kocyns/LaserSprint-ESP32/docs/20261004_163319 - kopie.jpg

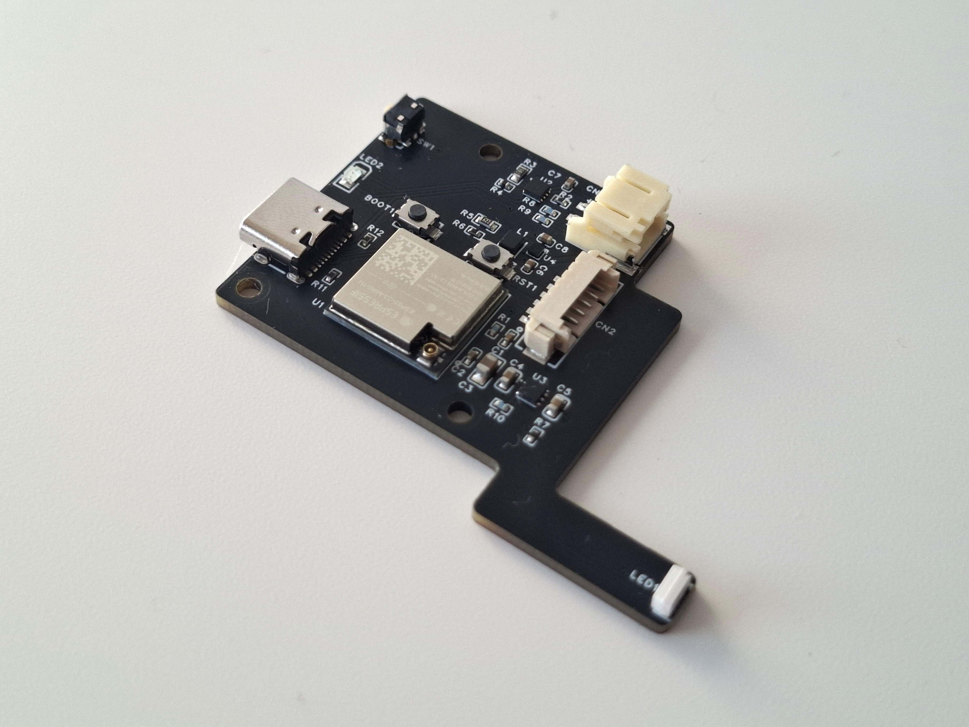
docs/20261004_163319 - kopie.jpg
