kocyns/LaserSprint-ESP32/docs/20261004_163330.jpg

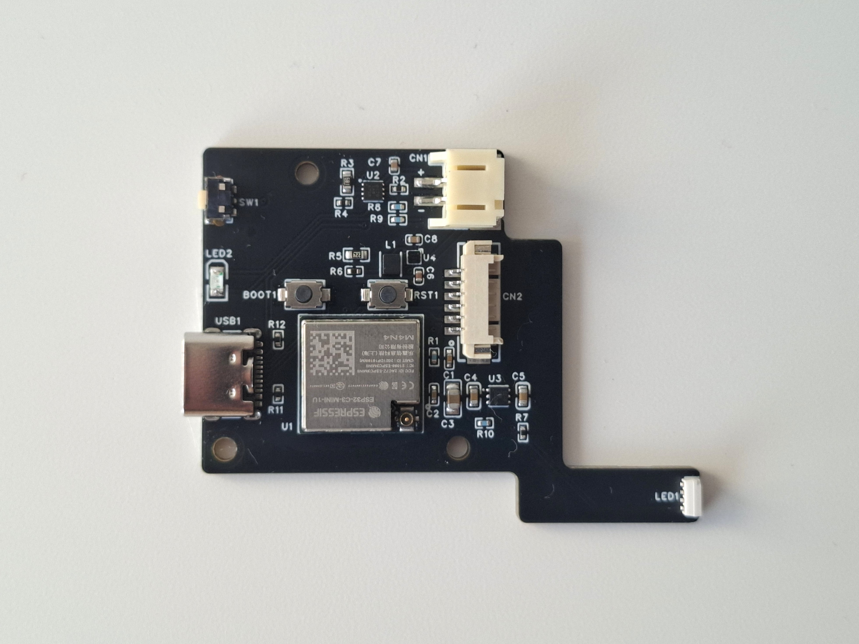
docs/20261004_163330.jpg
