kocyns/LaserSprint-ESP32/docs/EN_assembly_laser_sprint.pdf

# Assembly Guide

# Laser Sprint

V1.0

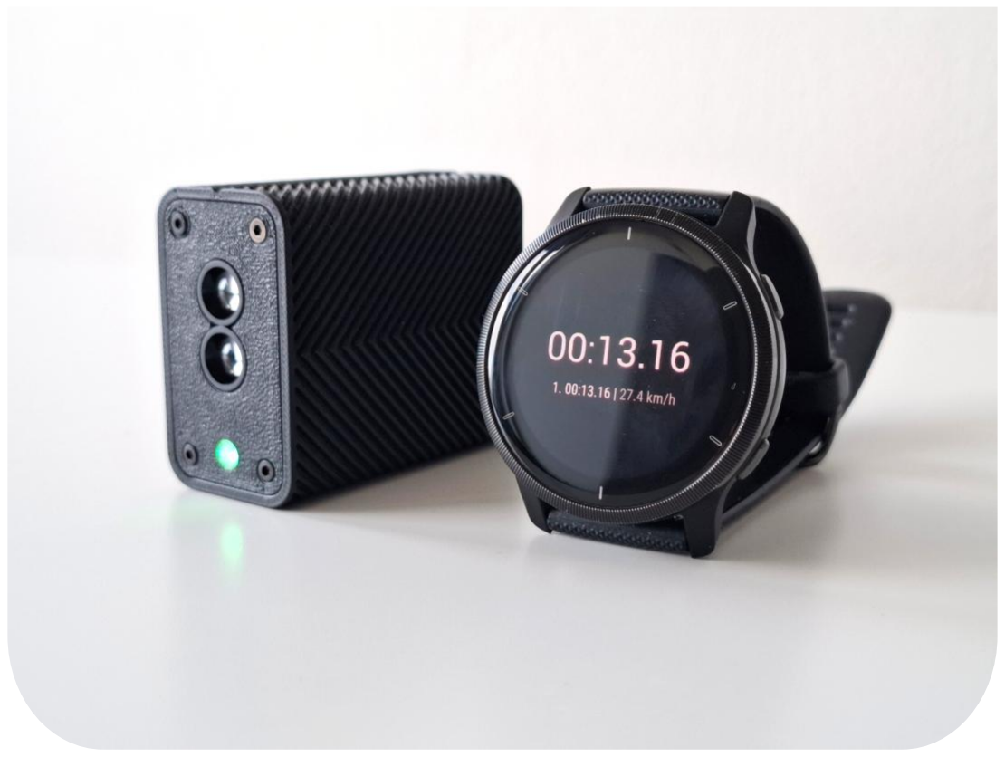
[picture p6: figure]

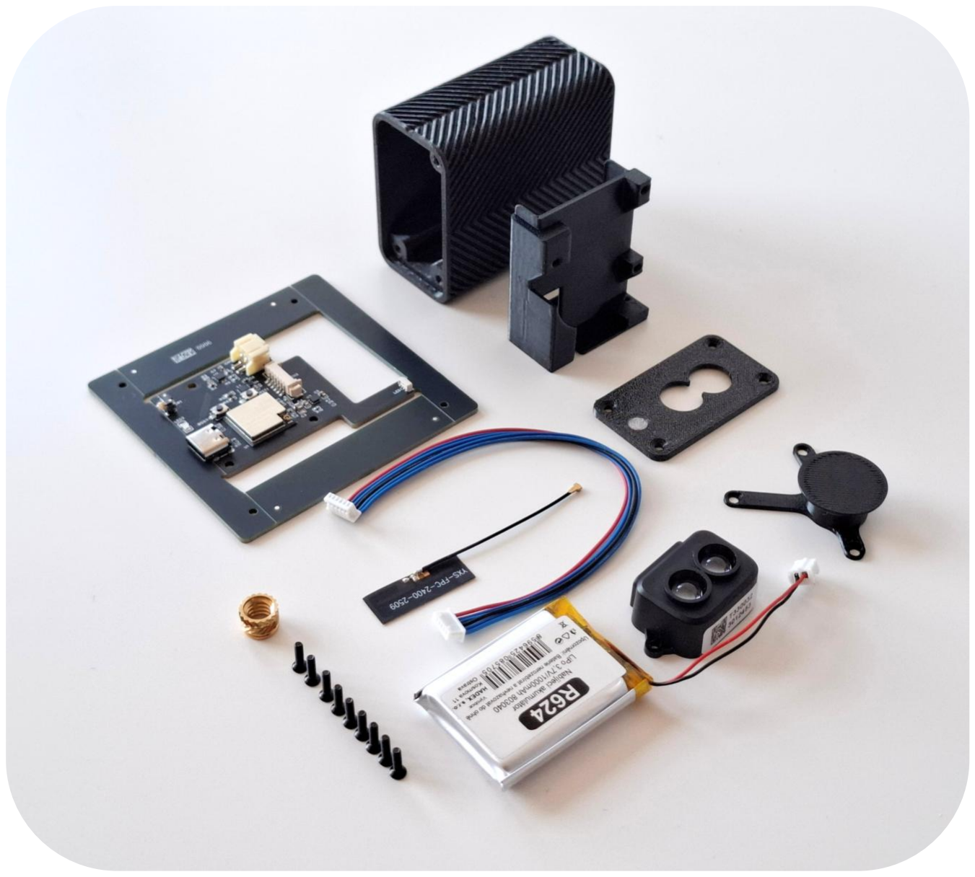
[picture p7: figure]

## What accessories/tools will you need?

- Custom PCB: • Pre-assembled Laser Sprint board ( (https://www.pcbway.com/project/shareproject/Laser_Sprint_5ba1c15b.html)PCBWay

) (https://www.pcbway.com/project/shareproject/Laser_Sprint_5ba1c15b.html)
- LiDAR Sensor: • TF-Luna ToF LiDAR
8m (UART)
- LiPo Battery: • 3.7V 1000mAh (Size 803040 / ~40 x30mm)
- BLE Antenna: • 2.4GHz 3dBi with IPEX

### 3 connector

- Tripod Mount: • 1/4"-20 UNC Threaded Brass Insert (Short) • Screws: • M2x8mm Screws for 3D Printed Case • 3D Printed Enclosure • Download 3D model MakerWorld

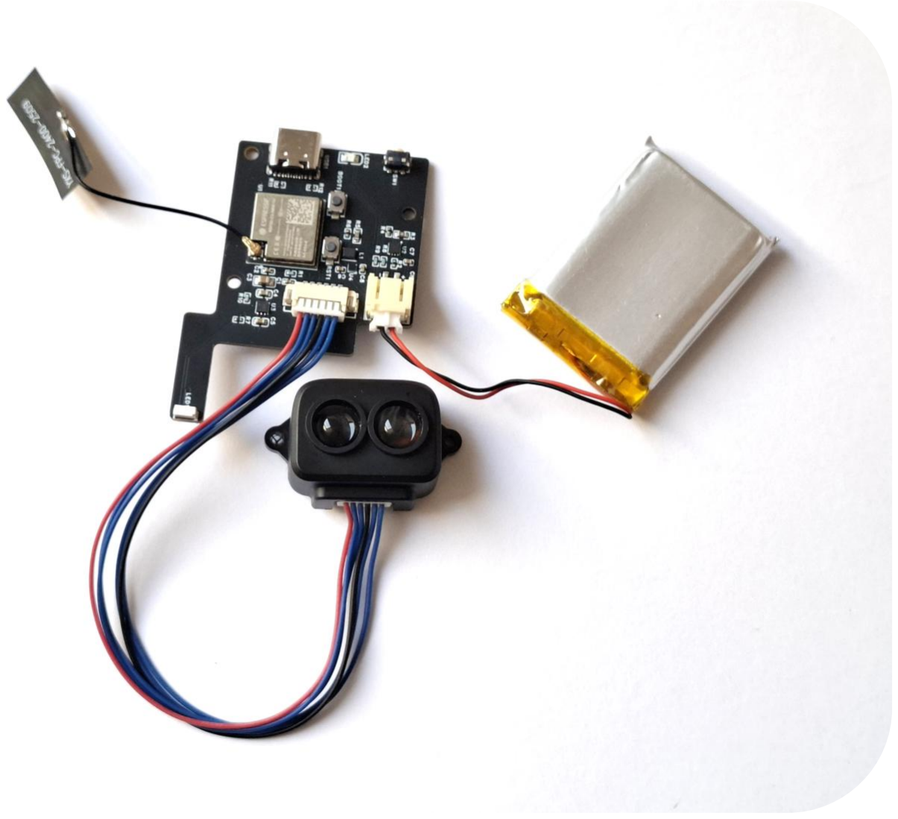
[picture p8: figure]

## Let’s start!

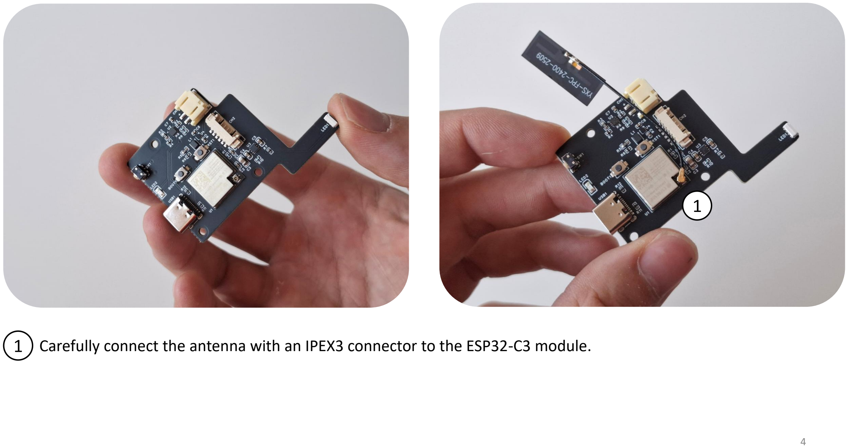
[picture p9: page 4]

1 Carefully connect the antenna with an IPEX3 connector to the ESP32-C3 module.

1

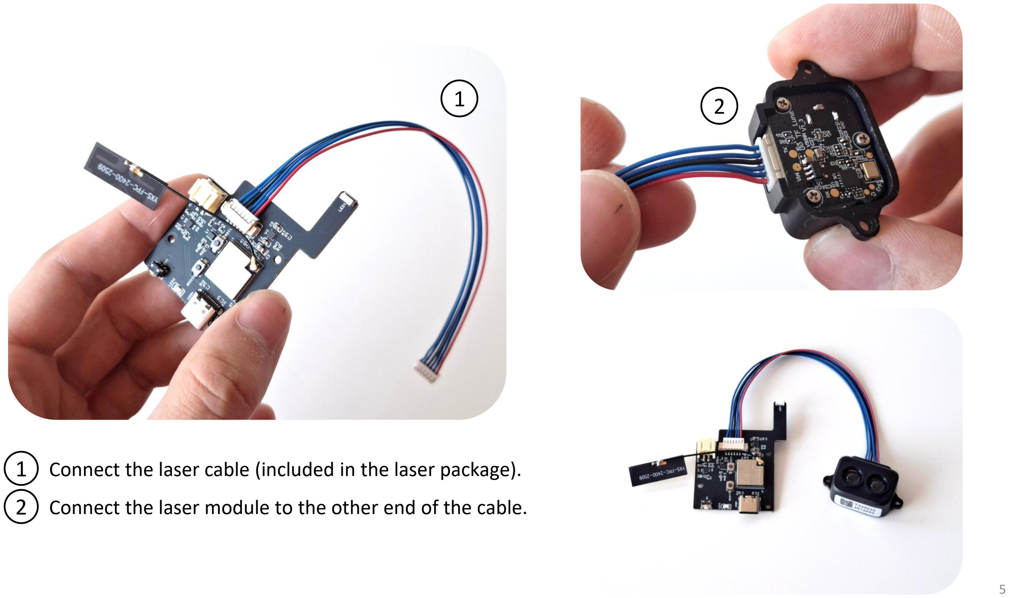
[picture p10: page 5]

Connect the laser cable (included in the laser package).

Connect the laser module to the other end of the cable.

1
2
1 | 2

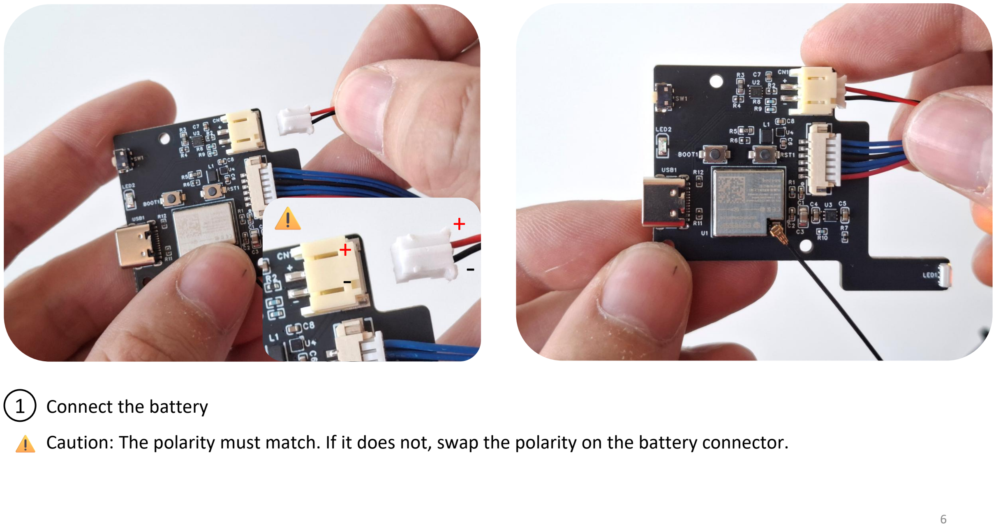
[picture p11: page 6]

Connect the battery

Caution: The polarity must match. If it does not, swap the polarity on the battery connector.

1

+

+

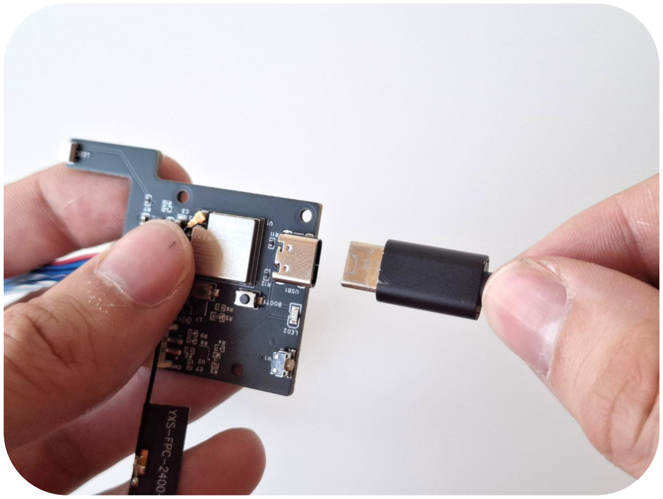
[picture p12: figure]

## Let's upload the firmware

## Before you start:

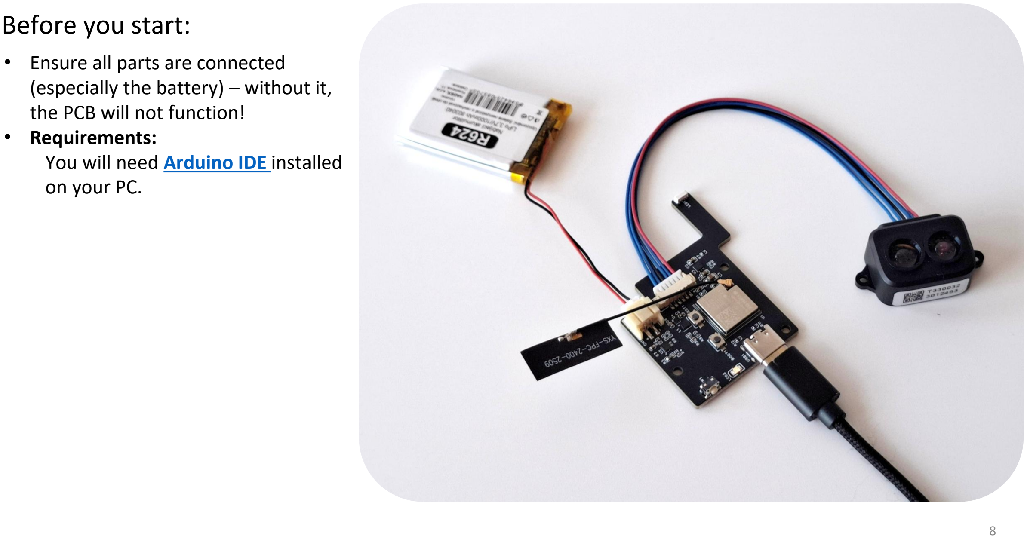
[picture p13: page 8]

M2.5 Stainless Steel Button Head Cap Machine Screws (BHCS) (https://eu.store.bambulab.com/products/m2-5-button-head-cap-machine-screws-bhcs?id=47966811652444)

- Ensure all parts are connected (especially the battery) – without it, the PCB will not function!
- Requirements:
You will need Arduino IDE (https://www.arduino.cc/en/software/) installed on your PC.

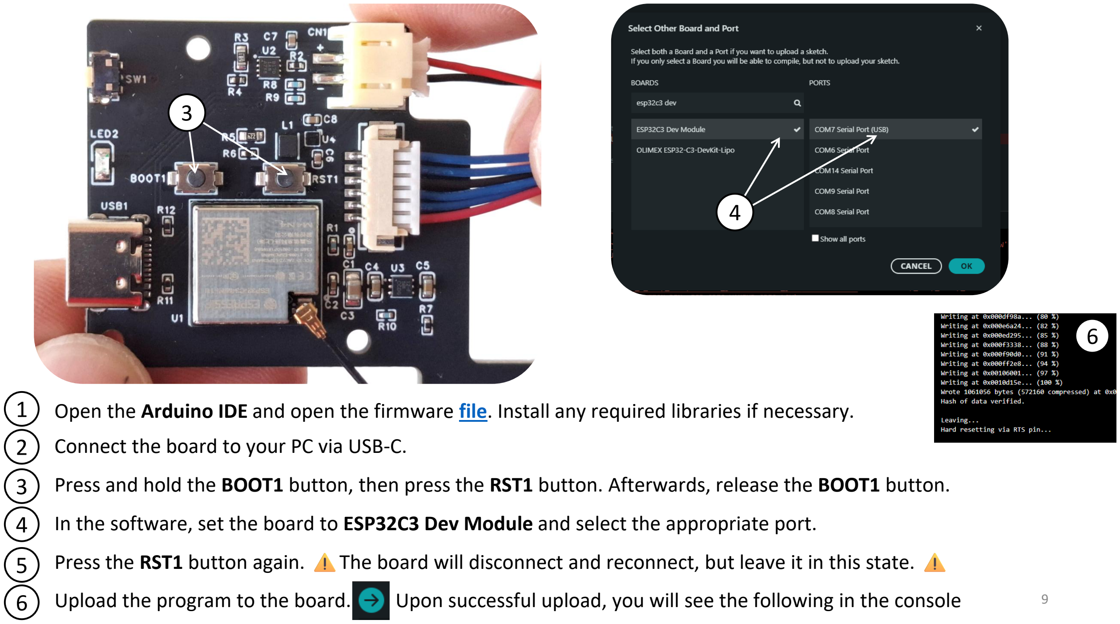
[picture p14: page 9]

Open the Arduino IDE and open the firmware file. (https://github.com/kocyns/LaserSprint-ESP32/blob/main/firmware/V2_1_4.ino) Install any required libraries if necessary.
Connect the board to your PC via USB-C.

Press and hold the BOOT1 button, then press the RST1 button. Afterwards, release the BOOT1 button.

In the software, set the board to ESP32C3 Dev Module and select the appropriate port.

Press the RST1 button again. | The board will disconnect and reconnect, but leave it in this state.
Upload the program to the board. | Upon successful upload, you will see the following in the console

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
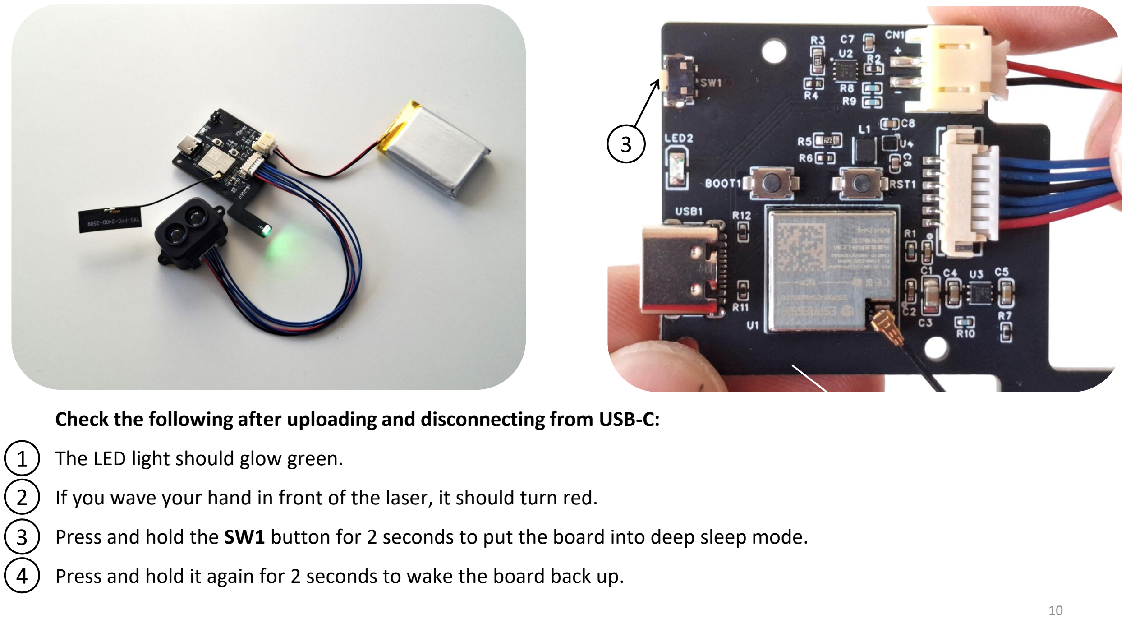
[picture p15: page 10]

Check the following after uploading and disconnecting from USB-C:

The LED light should glow green.

If you wave your hand in front of the laser, it should turn red.

Press and hold the SW1 button for 2 seconds to put the board into deep sleep mode.

Press and hold it again for 2 seconds to wake the board back up.

2

4

1

3

3

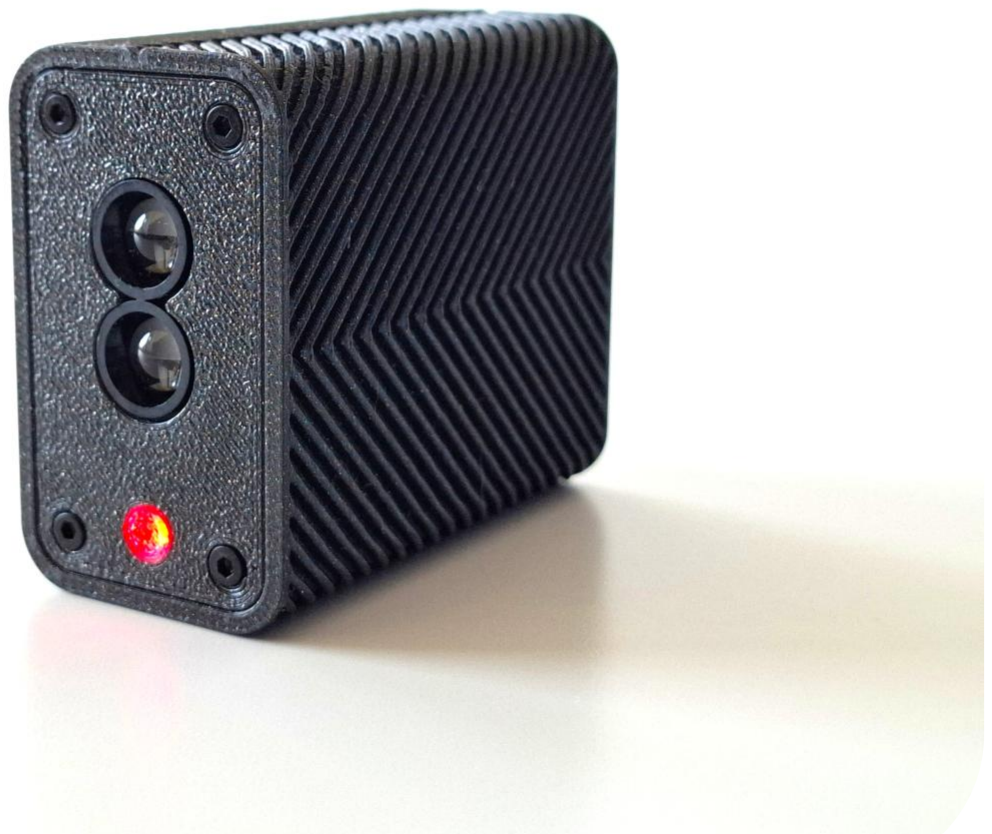
[picture p16: figure]

## Let's put it into the enclosure

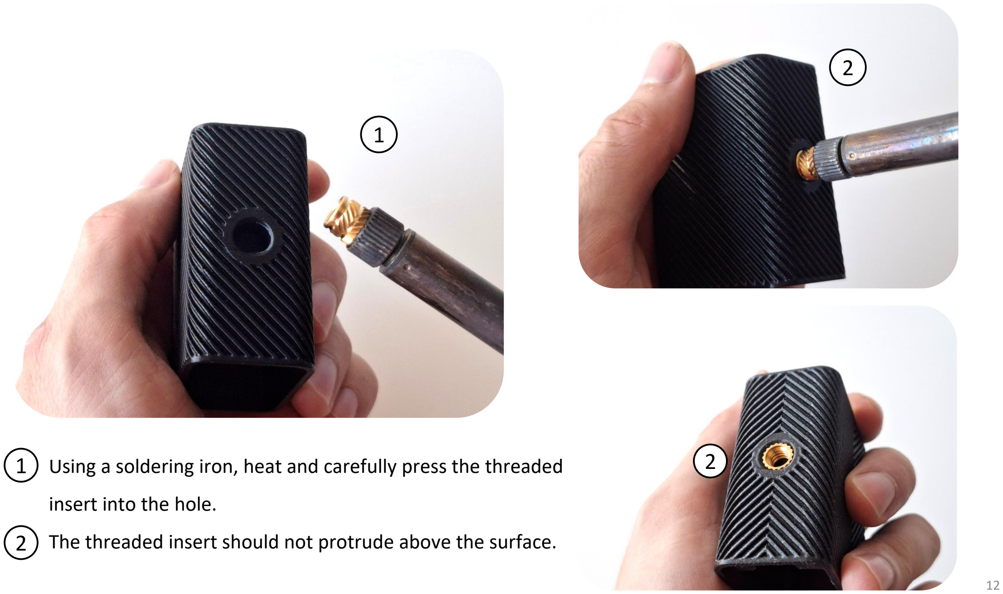
[picture p17: page 12]

Using a soldering iron, heat and carefully press the threaded

insert into the hole.

The threaded insert should not protrude above the surface.

1

2

1

2

2

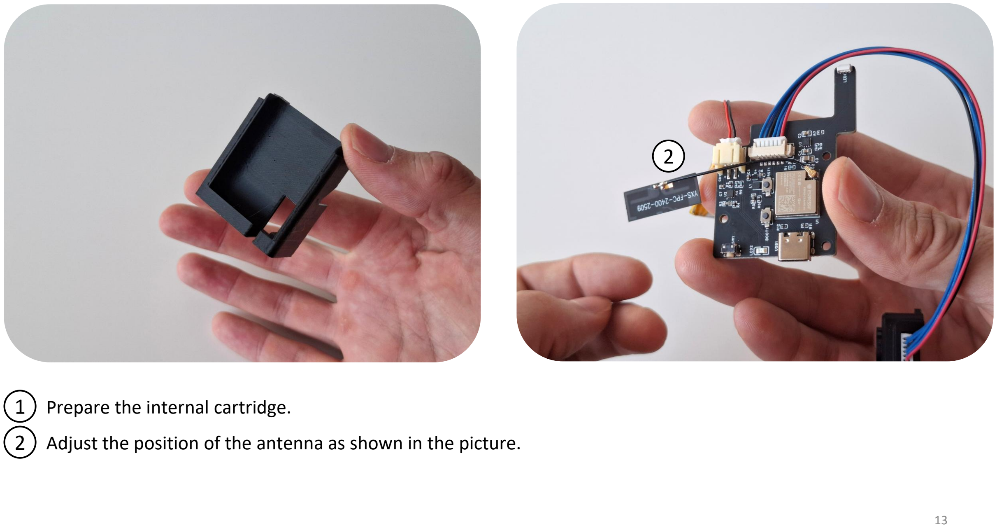
[picture p18: page 13]

Prepare the internal cartridge.

Adjust the position of the antenna as shown in the picture.

2

1
2

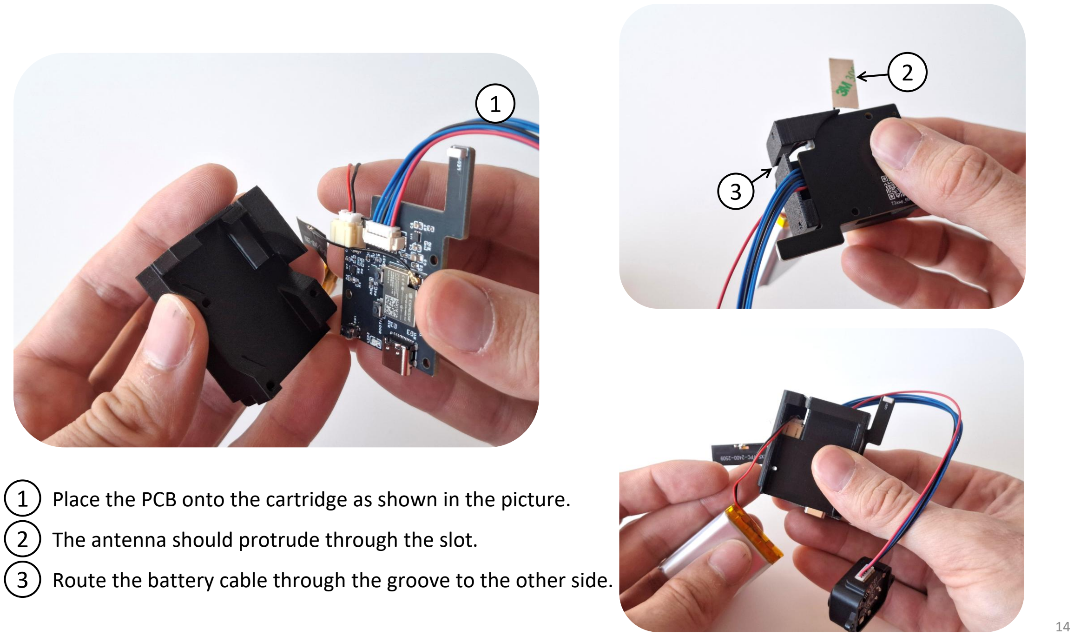
[picture p19: page 14]

Place the PCB onto the cartridge as shown in the picture.

The antenna should protrude through the slot.

Route the battery cable through the groove to the other side.

1
2

1

3

2

3

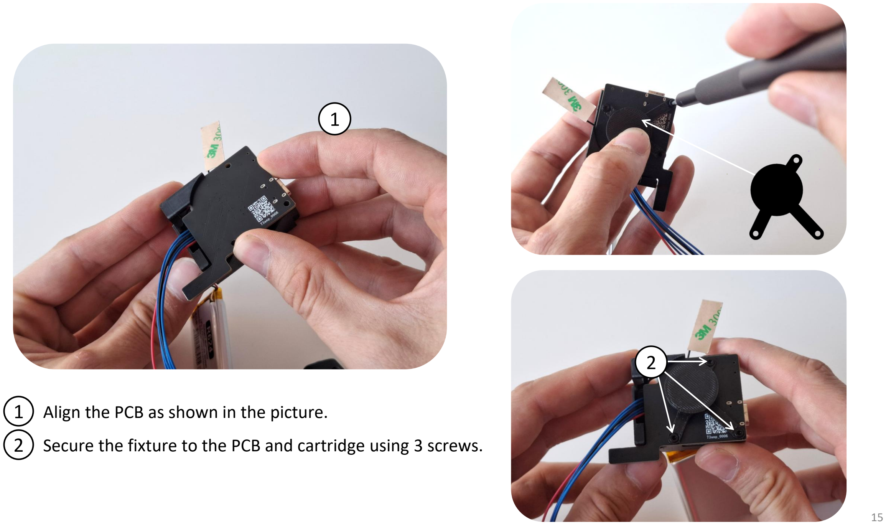
[picture p20: page 15]

Align the PCB as shown in the picture.

Secure the fixture to the PCB and cartridge using 3 screws.

1
2

1

2

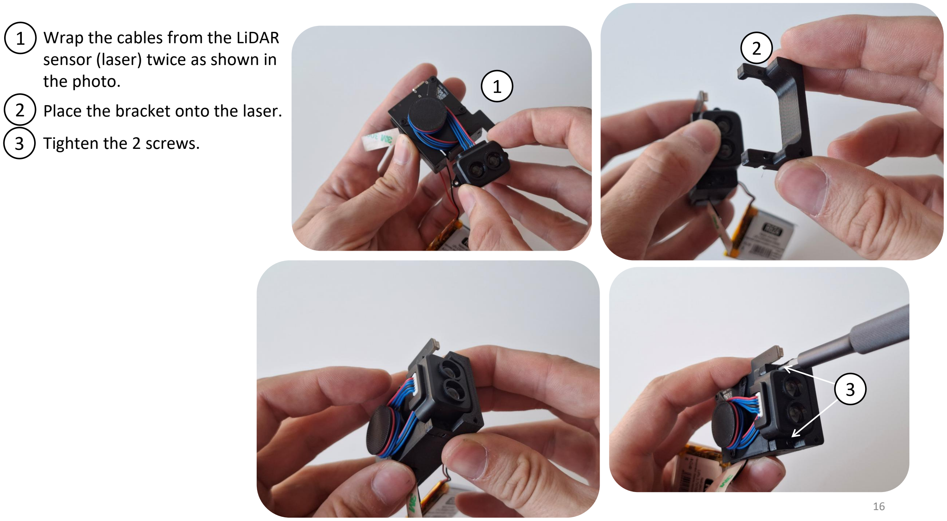
[picture p21: page 16]

Wrap the cables from the LiDAR sensor (laser) twice as shown in the photo.
Place the bracket onto the laser.

Tighten the 2 screws.

1

2
3

2

1

3

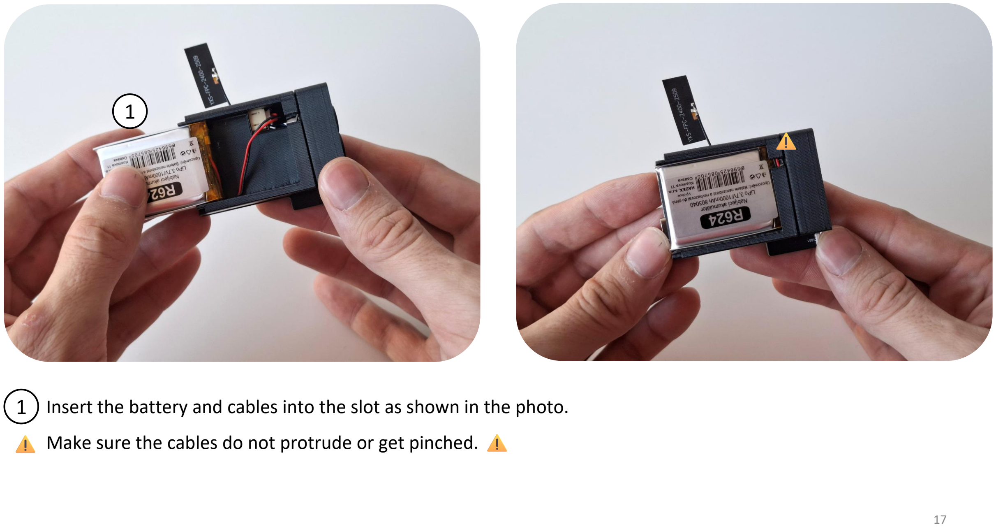
[picture p22: page 17]

Insert the battery and cables into the slot as shown in the photo.

Make sure the cables do not protrude or get pinched.

1

1

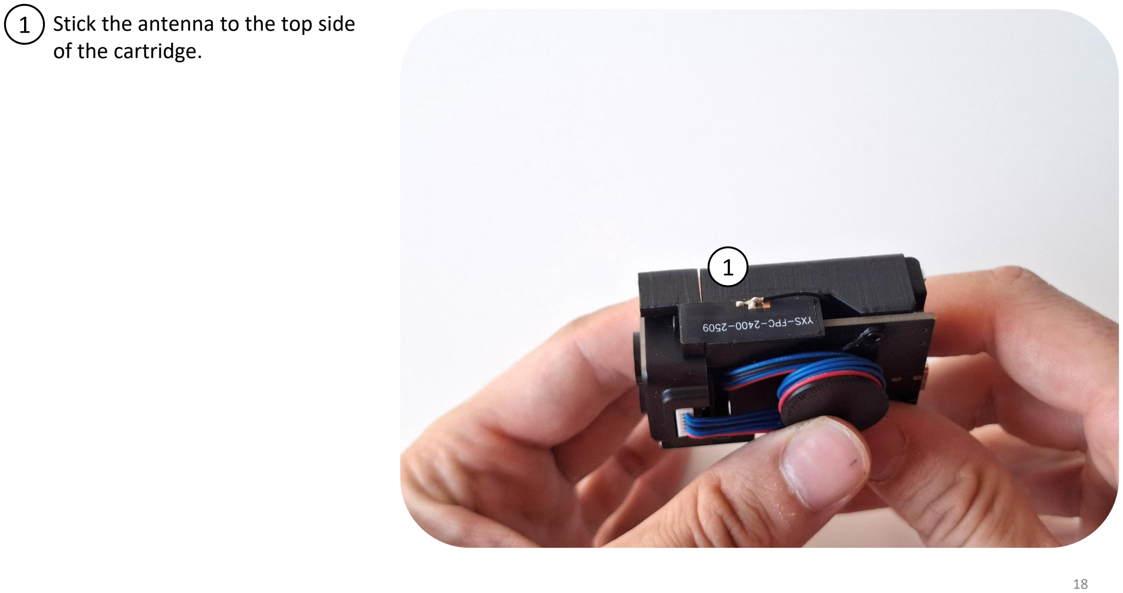
[picture p23: page 18]

Stick the antenna to the top side of the cartridge.

1

1

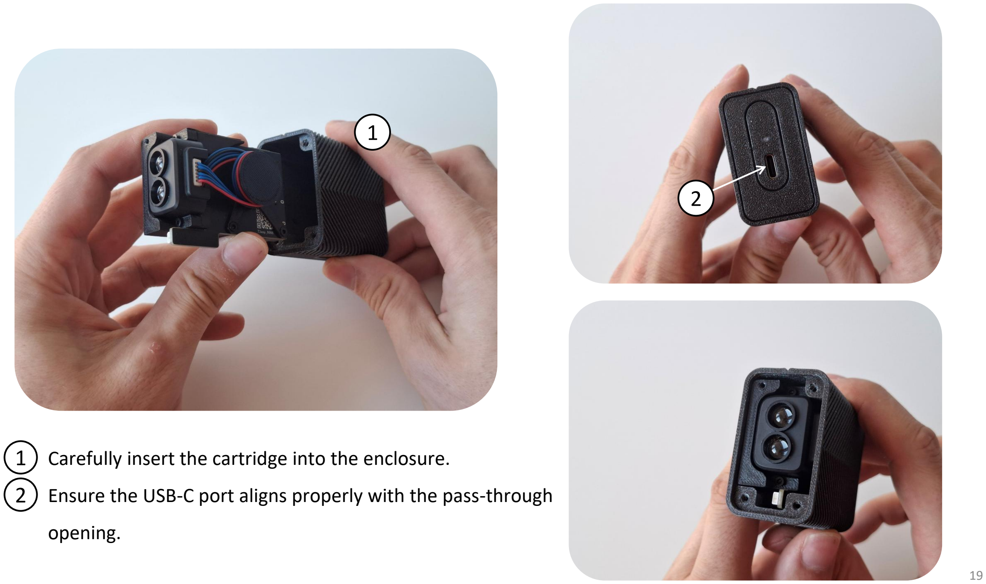
[picture p24: page 19]

Carefully insert the cartridge into the enclosure.

Ensure the USB-C port aligns properly with the pass-through

opening.

1
2

1

2

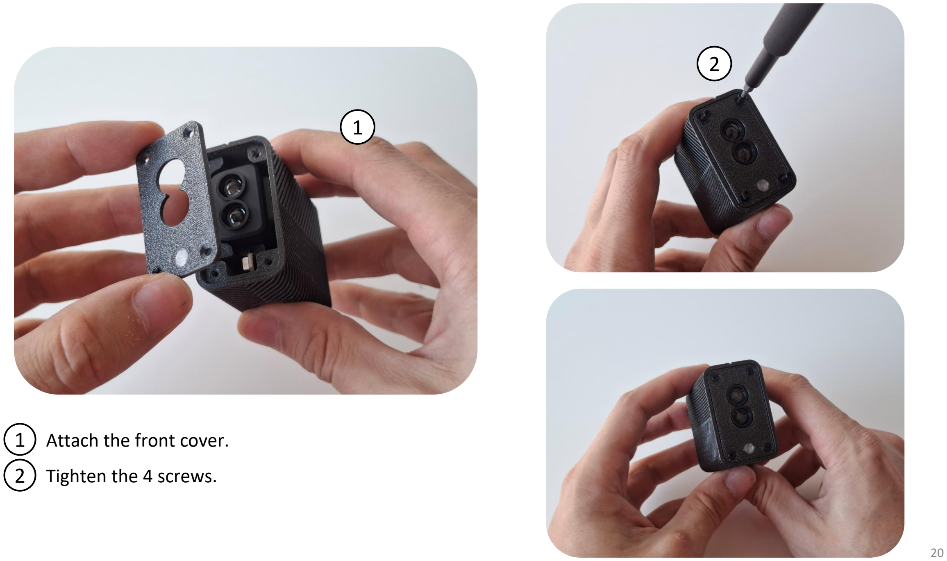
[picture p25: page 20]

Attach the front cover.

Tighten the 4 screws.

1
2

1

2

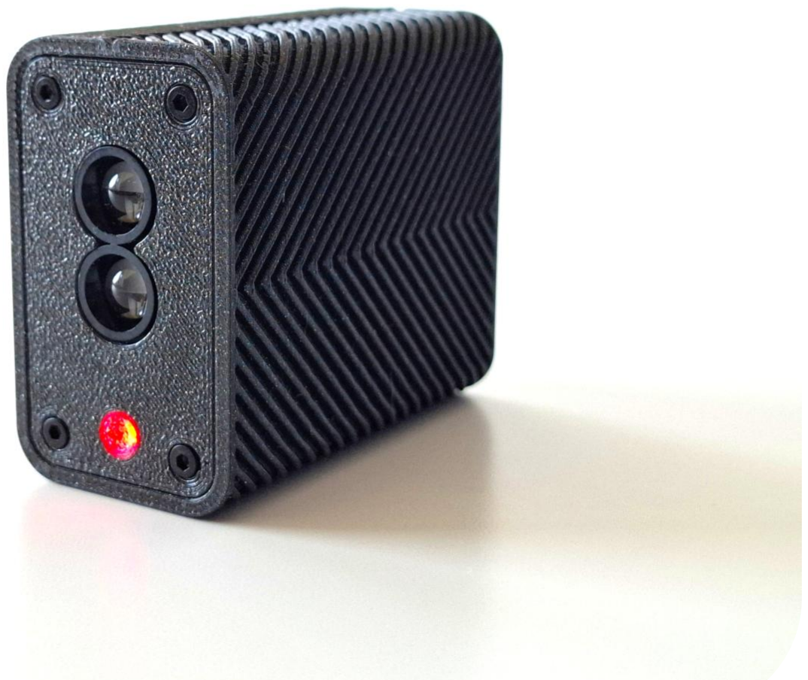
[picture p26: figure]

## Ready for RUN!
